cCbillCc/1A2B-game-console/s1120418_final_project_report.pdf

# 基於 RISC-V Core 的 FPGA 1A2B 遊戲機

## Final Project Report for YZU 114-2 EEB318A " Digital System Design with Lab"

Name: 李俊樨
Student ID Number: 1120418

Abstract—本專題在 Basys 3 上實作了 Single-Cycle RISC-V 處理器，並透過 MMIO 整合七段顯示器與控制單元，成功運 行一個互動式 1A2B 遊戲機。

Keywords—RISC-V、FPGA

I. INTRODUCTION
隨著嵌入式系統與數位電路設計技術的快速發展，開
放原始碼的 RISC-V 指令集架構因其模組化、可擴充及 低授權門檻等特性，逐漸成為處理器設計與教學研究的
重要平台。相較於傳統以硬體有限狀態機實現應用邏輯
的方式，基於處理器核心的系統設計能夠透過軟體與硬
體協同運作，提升系統功能的彈性與可維護性。因此，
本專題以 FPGA 平台為基礎，設計並實作一套基於
RISC-V Core 的 1A2B 互動式猜數字遊戲機，以驗證微處 理器架構、周邊整合與軟硬體協同設計之可行性。

本系統成功於 Basys 3 FPGA 開發板上建置一顆單週 期 32 位元 RISC-V 微處理器核心，並透過記憶體映射輸 入輸出（Memory-Mapped I/O, MMIO）機制整合按鈕、 七段顯示器及其他周邊模組。系統共提供四種操作模式：
Mode 00 為正常編輯模式，玩家可透過實體按鈕輸入與 修改四位不重複數字；Mode 01 為猜測次數顯示模式， 可即時查看目前累積的猜測次數；Mode 10 為歷史紀錄 瀏覽模式，透過資料記憶體所建構之軟體堆疊保存並查
閱過往猜測紀錄及其對應結果；Mode 1111 則為除錯模 式，可直接顯示系統產生之謎底，以利功能驗證與系統
測試。

在系統設計方面，導入 RISC-V 處理器核心相較於純 硬體狀態機實作具有顯著優勢。首先，遊戲初始化階段
需利用線性 回饋移位 暫 存器（ Linear Feedback Shift

Register, LFSR）產生偽隨機數，並進一步篩選出四位互 不重複的數字作為遊戲答案；其次，在玩家送出猜測結
果後，系統需執行多組數字之交叉比對，以計算對應的
A 與 B 數量；此外，為支援歷史紀錄瀏覽功能，系統亦 需透過軟體方式管理堆疊指標，並利用 ‘sw’ 與 ‘lw’ 等指 令完成資料儲存與讀取。上述功能皆涉及較複雜的流程
控制與資料管理，若完全以硬體狀態機實現，將大幅增
加設計複雜度與維護成本；透過 RISC-V 核心執行組合 語言程式，則可將運算邏輯交由軟體處理，而硬體專注
於資料通路與周邊介面控制，充分展現現代系統單晶片
（System-on-Chip, SoC）之軟硬體協同設計理念。

此外，本專題在實際實作過程中亦針對處理器微架構
進行優化。原始設計規劃於資料通路中配置獨立的 Shift Left One 單元，以處理 Branch 指令之立即數位移運算； 然而在 FPGA 實作階段，為簡化內部連線並縮短關鍵路 徑，將該位移邏輯整合至 Immediate Generator（ImmGen） 模組內部完成。此項調整不僅降低了硬體複雜度與模組
間耦合度，亦提升了整體系統的時序穩定性與 FPGA 實 機運行效能，驗證了微架構優化對數位系統設計的重要
性。

II. SYSTEM ARCHITECTURE & HARDWARE DESIGN
本專題之整體硬體系統架構如 Fig. 1 所示。系統微架 構係以 NYCU CO2026 Lab3 所提供之單週期（Single-Cycle）RISC-V 處理器核心為基礎（如 Fig. 2 所示），並 進一步進行功能擴充與系統級晶片（System-on-Chip, SoC）整合，以滿足 1A2B 猜數字遊戲之互動控制與資 料管理需求。

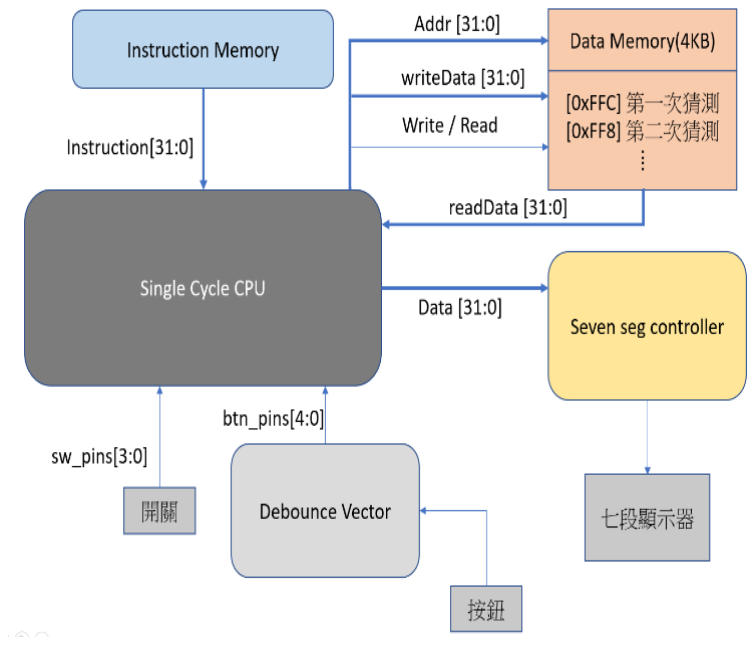
[picture p1: figure]
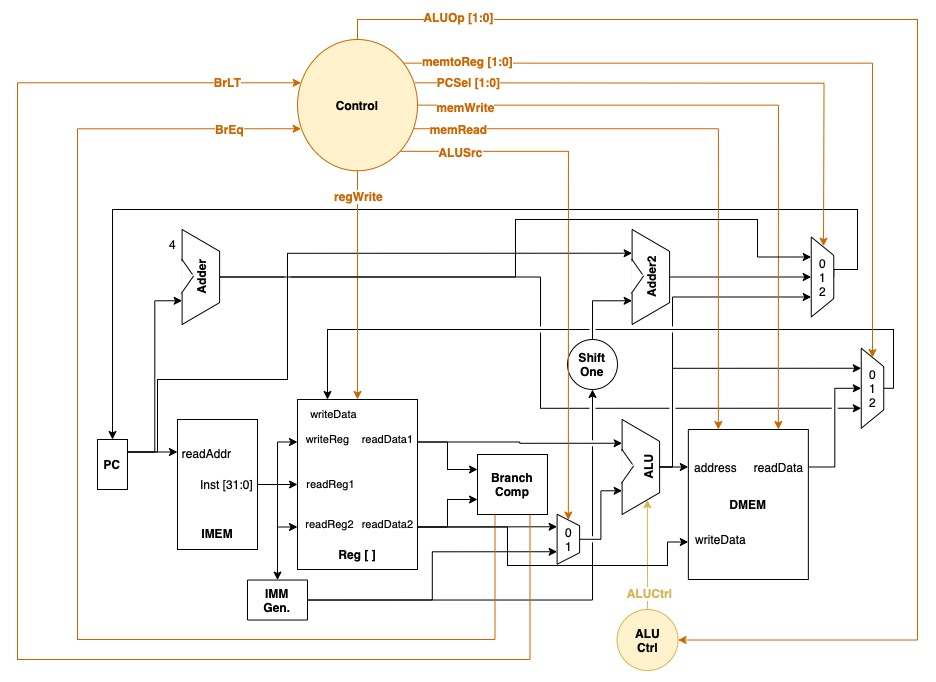
[picture p2: figure]

Fig. 1 System Architecture | Fig .2 Single Cycle CPU

為實現遊戲系統所需之運算與儲存功能，本架構進行
了三項主要硬體設計優化。首先，將資料記憶體（Data Memory）容量擴充至 4 KB，並自 CPU 核心內部獨立配 置於頂層模組，以利系統進行全域記憶體映射輸入輸出
（Memory-Mapped I/O, MMIO）之位址解碼與周邊資源 管理。其次，為降低資料通路之硬體複雜度並縮短關鍵
路徑，將原微架構中獨立的 Shift Left One 單元整合至立 即數產生器（Immediate Generator, ImmGen）模組內部， 以簡化訊號傳遞流程並提升時序效能。

此外，系統透過 MMIO 機制整合七段顯示器控制器
（Seven Seg Controller）與按鈕防彈跳（Debounce）模組。 其中，七段顯示器負責遊戲資訊與系統狀態之即時顯示，
而防彈跳模組則用於消除機械按鈕切換時所產生之訊號
抖動，確保輸入訊號的穩定性與可靠性。藉由上述軟硬
體整合設計，本系統成功建立一個具備處理器運算能力、
周邊控制功能以及互動式遊戲應用之 FPGA SoC 平台

III. RISC-V SOFTWARE IMPLEMENTATION
本專題之核心遊戲邏輯完全由 RISC-V 組合語言編譯 之機器語言驅動。為了提升系統的可讀性與模組化程度，
軟 體 架構 依據 實 體開 關所 切 換的 四大 模 式（ Mode 00/01/10/11），將程式流程切分為四大核心核心區塊。 以下針對各區塊之軟體演算法、暫存器配置與實體按鈕
互動進行詳細說明：
A. 遊戲初始化與開局謎底生成
當系統啟動時，玩家需先將最左側控制開關切換至啟
用狀態，使系統進入待機模式。此時七段顯示器將閃爍
顯示訊息 (1A2b)，引導玩家按下【中鍵】開始遊戲。

在等待玩家按下【中鍵】的期間，處理器持續執行偽
隨 機 數 產 生 器 （ Pseudo-Random Number Generator, PRNG）。由於使用者按下按鈕的時刻具有不可預測性， 系統於主輪詢迴圈（Polling Loop）中以 FPGA 100 MHz 系 統 時 脈 持 續 更 新 線 性 回 饋 移 位 暫 存 器 （ Linear Feedback Shift Register, LFSR）之狀態值。當偵測到【中 鍵】被按下時，處理器立即擷取當前 LFSR 內容作為亂 數種子，並透過除法、取餘數及重複性檢查等運算流程，
篩選出四個互不重複的十進位數字，依序儲存於答案暫
存器（s4 至 s7）中，完成遊戲謎底之動態生成。

謎底產生完成後，系統進一步執行遊戲環境初始化程
序，包括堆疊指標、猜測次數計數器以及相關全域暫存
器之設定，並建立歷史紀錄儲存區的初始狀態。完成初
始化後，系統即進入正式遊戲階段，等待玩家輸入第一
組猜測數字。
B. 一般猜測模式與 A/B 判定邏輯（Mode 00) 謎底生成後，系統進入 Mode 00 的主要遊戲循環。玩 家可透過實體按鈕即時編輯欲猜測的數字，並由 CPU 進 行合法性檢查與結果判定：
1. 數值編輯：游標預設於最高位。玩家按下【左鍵】或 【右鍵】可切換當前欲修改的七段顯示器欄位；按
下【上鍵】或【下鍵】則會對該位數暫存器進行 +1
或 -1 的 0~9 循環修改，並透過 MMIO 即時更新七段 顯示器畫面。
2. 合法性檢查：當玩家調整完四位數並按下【中鍵】確 認送出時，CPU 首先會執行輸入判定。若偵測到玩

家輸入了重複的數字或開頭為 0，畫面將強制鎖定
並閃爍顯示錯誤代碼 CEDD（Err），拒絕本次猜測， 直到玩家修正。
3. A/B 數量統計與堆疊：若輸入合法，CPU 將啟動全域 比對電路，將輸入暫存器與答案暫存器進行交叉比
對。位置與數字皆正確者增加 A 的計數；數字正確
但位置錯誤者增加 B 的計數。判定完成後，總猜測
次數自增一次。隨後，CPU 執行暫存器堆疊寫入指
令，並顯示結果在畫面中。
C. 猜測次數統計與作弊除錯模式（Mode 01 & Mode 11） 為了提供多維度的遊戲回饋與開發除錯便利性，系統
利用開關控制切換至次要輔助模式：
1. 次數顯示（Mode 01）：當玩家將實體指撥開關撥至 01 時，CPU 將暫停 Mode 00 的編輯畫面，改為讀取內部 計數暫存器，並將目前為止累積的「成功猜測總次數」
轉為 BCD 碼映射至七段顯示器上，方便玩家評估目前的 遊戲進度。
2. 除錯模式（Mode 11）：為避免除錯功能於一般操作過 程中被誤觸發，本系統對原始設計進行安全性優化。原
規劃僅以最後兩個開關組合（2'b11）作為除錯模式的啟 動條件，使用者在切換歷史紀錄模式（2'b10）時，可能 因操作失誤而意外進入除錯模式。為提升系統可靠性，
本設計改採四位元全開（4'b1111）安全互鎖機制作為除 錯模式的唯一啟動條件。

當 CPU 讀取開關控制暫存器（0x4000000C）時，會 同步檢查四個指撥開關的狀態。僅當所有開關皆處於啟
用狀態（SW[3:0] = 4'b1111）時，系統才會進入除錯模 式，並將儲存在答案暫存器中的四位謎底數字輸出至七
段顯示器，以供開發與驗證使用。

若開關組合為其他狀態，例如 4'b0011、4'b0111 或其 他非 4'b1111 的組合，系統將視為無效模式（Invalid Mode），維持原有顯示內容或執行保護性隱藏機制，不 會揭露遊戲答案。透過此設計，系統能有效避免因操作
失誤而導致謎底曝光，同時提供開發過程與驗證階段快
速檢查偽隨機數產生器與遊戲邏輯正確性的途徑。
D. 歷史紀錄查詢功能（Mode 10）
當切換至 Mode 10 時，程式將啟動核心的暫存器堆疊動 態瀏覽機制。系統將暫存器 a7 鎖定為最新的堆疊指標位 置，並允許玩家使用按鈕自由翻閱 Data Memory 中的所 有歷史猜測：
1. 切換：在瀏覽歷史紀錄時，玩家按下【中鍵】可對標 記 t3 進行 0 與 1 的狀態翻轉，實現七段顯示器在「猜測 數字」與「猜測結果」之間的即時畫面切換
2. 翻頁：玩家按下【上鍵】時，程式在進行邊界安全檢 查（未超越初始堆疊邊界 0xFF8）後，驅動 sp 指標向舊 資料方向移動；按下【下鍵】時，在確保未超越最新資
料邊界（a7）的前提下，驅動 sp 指標向新資料移動。且 每次換頁成功時，狀態標記 t3 強制歸零，確保優先呈現 該筆紀錄的「猜測數字」。

IV. VERIFICATION & TESTING RESULTS
將最終產生的 Bitstream 導入 FPGA 中，並進行功能 測試：
A. 實作與測試結果

TABLE I. TEST

成果展示影片連結：

https://youtu.be/x1N_rKJL9kM?si=fvMqYfRA33y_zNe1
B. 問題與除錯
在實作過程中所遭遇的最大硬體挑戰在於 Instruction Memory 與處理器程式執行之間的時序耦合問題。由於 系統 啟動 或 重設 釋放 的 瞬間 ， CPU 的取 指 執行 與 Instruction Memory 的加載同步開始，導致第一行指令在 尚未完全加載完成前處理器便已開始解碼執行，造成該
條指令形同被系統「吞噬」。由於本程式的第一行指令
恰好是用於初始化與存放七段顯示器 MMIO 映射位址的 關鍵核心指令，這使得系統在開局時便陷入位址指標污
染的狀態，在缺失螢幕顯示的情況下，完全無法找出問
題所在。然而，在先前的獨立周邊測試中，不論是按鈕、
開關或七段顯示器的 I/O 驗證皆能完全正常運作，經深 入比對程式碼後發現，該 I/O 測試程式內部包含一個完 整的無限迴圈，使得初始化與映射指令有機會被重複循
環執行；以此為關鍵線索，懷疑是常規遊戲程式在實機
部署時發生指令遺失所致。最終，透過在軟體程式開頭
主動加入一行無實質影響的「多餘緩衝指令（NOP）」， 成功確保了後續初始化邏輯的加載與執行，順利攻克此
項實機部署的時序瓶頸。
V. CONCLUSION & APPENDIX
A. 專題結論與成果總結
本期末專題成功於 Basys 3 FPGA 開發板上建構了一 台「基於 RISC-V 核心之 1A2B 互動式猜數字遊戲機」 。 藉由軟硬體協同設計（SoC）的架構思維，將標準的單

週期 RISC-V 處理器核心與外部擴充的 4KB 資料記憶體、 七段顯示器控制器及硬體按鈕防彈跳模組進行全域的記
憶體映射 I/O（MMIO）縫合 。在軟體層面，透過編譯 之組合語言程式，不僅實現了高隨機性的 PRNG 謎底生 成、單週期全域 A/B 判定演算法，更利用 Data Memory 的有限空間開發出高安全性的動態暫存器堆疊機制，賦
予系統流暢的歷史紀錄翻閱功能。本系統之實機測試結
果展現了極高的反應靈敏度與運算正確性，完美印證了
軟體控制靈活性與硬體時脈驅動高度分工之軟硬體整合
設計精髓。
B. 外部來源與開源專案使用說明
本專題之單週期微處理器核心係繼承並參考自
NYCU CO2026 Lab3 之單週期處理器設計藍本 ，並在該 基礎架構上進行了自主優化與核心修改，包含：
1. 將原微架構中獨立的左移單元移出並直接整合至立即 數產生器（ImmGen）內部，精簡了關鍵路徑之走線延 遲。
2. 建立頂層模組（top_soc.v），自主設計並實作了基於 地址解碼器（Address Decoder）與多工器（Mux）之全 域 MMIO 總線結構 。
3. 完全獨立編寫 1A2B 遊戲之 RISC-V 組合語言程式，並 導入了利用 sp 指標控制的動態堆疊歷史資料翻閱演算法。
C. AI 協作紀錄摘要
D. 個人貢獻說明
本專題由本人獨立完成所有設計與整合工作 。本人
的實際核心貢獻包括：獨自構思並規劃 1A2B 遊戲機的 互動機制 ；自主學習 Vivado 開發工具的操作、XDC 引 腳與 MMIO 位址的對應綁定 ；獨立測試並修改 Verilog 初始代碼以使其適應 Basys 3 開發板之硬體規範 ；完全 獨立編寫整套 1A2B 遊戲之 RISC-V 組合語言程式（包含 動態 LFSR 亂數、A/B 比對統計、Mode 11 安全遮罩及 Mode 10 堆疊翻頁邏輯）；以及獨立主導實機除錯、排 除首條指令遺失之時序瓶頸 ，並撰寫本篇成果結案報告 。
Case 測試情境 | 預期輸出結果 | 實際測試結果 | 判定
1 謎底初始化與除錯 | 功能測試 | 除錯功能正常運作，並成 功產生符合要求之謎底並 且未重複。 | 重複打開開關5次並進入除錯 模式查看謎底，皆為符合要求 之謎底並且不重複。 | PASS
2 | 左右切換功能測試 | 會根據左右鍵切換編輯目 標，並且最左邊往左會變 做右邊，最右邊往右會變 最左邊。 | 無論是在邊界還是在中間，都 能依照預期做切換。 | PASS
3 數字編輯測試 | | 使用上下鍵修改數值，預 期按上數值會增加，按下 則數值減少，並且9+1=0 ，0-1=9。 | 無論是在邊界還是在中間，都 能依照預期編輯數字。 | PASS
4 | 猜測結果測試 | 根據除錯模式得到的謎底 ，給出正確的結果。 | 按照謎底4801輸入猜測1237得 到0A1b正確判斷一個數字正確 但位置不正確。 | PASS
5 | 次數顯示測試 | 切換至次數顯示模式，顯 示猜測次數。 | 正確顯示猜測次數(2)。 | PASS
6 | 歷史查詢測試 | 切換至歷史查詢模式，會 先顯示上次猜測，按中鍵 時會顯示猜測結果，按上 下鍵切換查詢目標。 | 正常顯示歷史紀錄。 | PASS
7 | 正確答案測試 | 送出正確答案，交替顯示 顯示4A與猜測次數(3)。 4A與猜測次數。 | 送出正解4801後，顯示器交替 | PASS
8 | 違規猜測 | 如果送出的猜測包含重複 數字或者為0開頭，顯示 Err。 | 送出重複數字(2234)，顯示 Err，送出0開頭猜測(0234)， 一樣顯示Err。 | PASS
9 重製測試 | | 在正確之後按中鍵重新開 始，歷史紀錄與猜測次數 被正確清空。
歷史紀錄與猜測次數被清空。 | PASS | 使用AI的地方 | 我問了什麼 | AI提供什麼協助 | 我如何檢查與修改
Verilog輔助 | 根據我的架 構給出修正 意見。 | 給出修正意見。 | 參考他的意見進行 修改，並反覆嘗試 直到如預期運作。
Vivado如何使 用 | Vivado如何 使用? | 給出操作提示。 | 根據提示操作，如 產生最終Bitstream 的流程。
程式輔助 | 為何在歷史 查詢模式， 按鍵操作會 比正常模式 卡? | 指出我在歷史查 詢模式中，判斷 按鍵鬆開的指令 出現在錯誤位置 ，導致在我未按 按鍵的情況下要 求我放開按鍵， 導致無法進入檢 查有按按鍵的指 令。 | 調整指令，必須在 有按按鍵的情況下 才檢查是否鬆開。
報告潤色 | 以上是我的 內容，幫我 潤色一下。 | 潤色我給他的文 字。 | 篩選出我需要的內 容，複製到報告 中。

E. 未完成項目與未來改善
雖然本專題已在有限的時間與技術背景下，成功透過軟
硬體協同設計實現了完整且具備安全互鎖機制的 1A2B 猜數字遊戲 ，但未來仍有以下工程優化空間：
1. 硬體描述語言（Verilog）之底層重構：受限於對 HDL 語言的不熟悉，頂層周邊控制電路多仰賴 AI 優化與密集 實機測試。未來可規劃深入修讀系統晶片或數位電路相
關課程，將現有之 MMIO 總線與解碼器重構為更符合業 界標準之 AMBA APB 或 AXI-Lite 總線協議，以提升核 心之擴充性。
2. 中斷驅動架構：目前按鈕與模式切換皆採用 CPU 軟體 輪詢版本 ，若未來能將實體按鈕觸發整合至 RISC-V 的 非同步中斷控制，將能徹底釋放 CPU 的運算資源 。
F. GitHub 專案倉庫連結
專案 GitHub 連結： https://github.com/cCbillCc/1A2B-game-console (https://github.com/cCbillCc/1A2B-game-console)

REFERENCES

[1] National Yang Ming Chiao Tung University (NYCU), "Lab 3: Single Cycle CPU," Course Project for CO2026 Computer Organization, [Online].
Available: https://github.com/nycu-caslab/CO2026/tree/main/Lab3
