cCbillCc/1A2B-game-console/Verilog/BranchComp.v

module BranchComp (
    input signed [31:0] A,B,
    output reg BrEq, BrLT
);
// BranchComp compares two inputs and then outputs BrEq and BrLT based on the result.
// TODO: implement your BranchComp here
// Hint: you can use operator to implement
    always @(*) begin
        BrEq = (A == B);
        BrLT = (A < B);
    end
endmodule
